lodewave/miata-na-cd/hardware/kicad/NACD.kicad_sch

## KiCad design hardware/kicad/NACD.kicad_sch (2026-10-19)

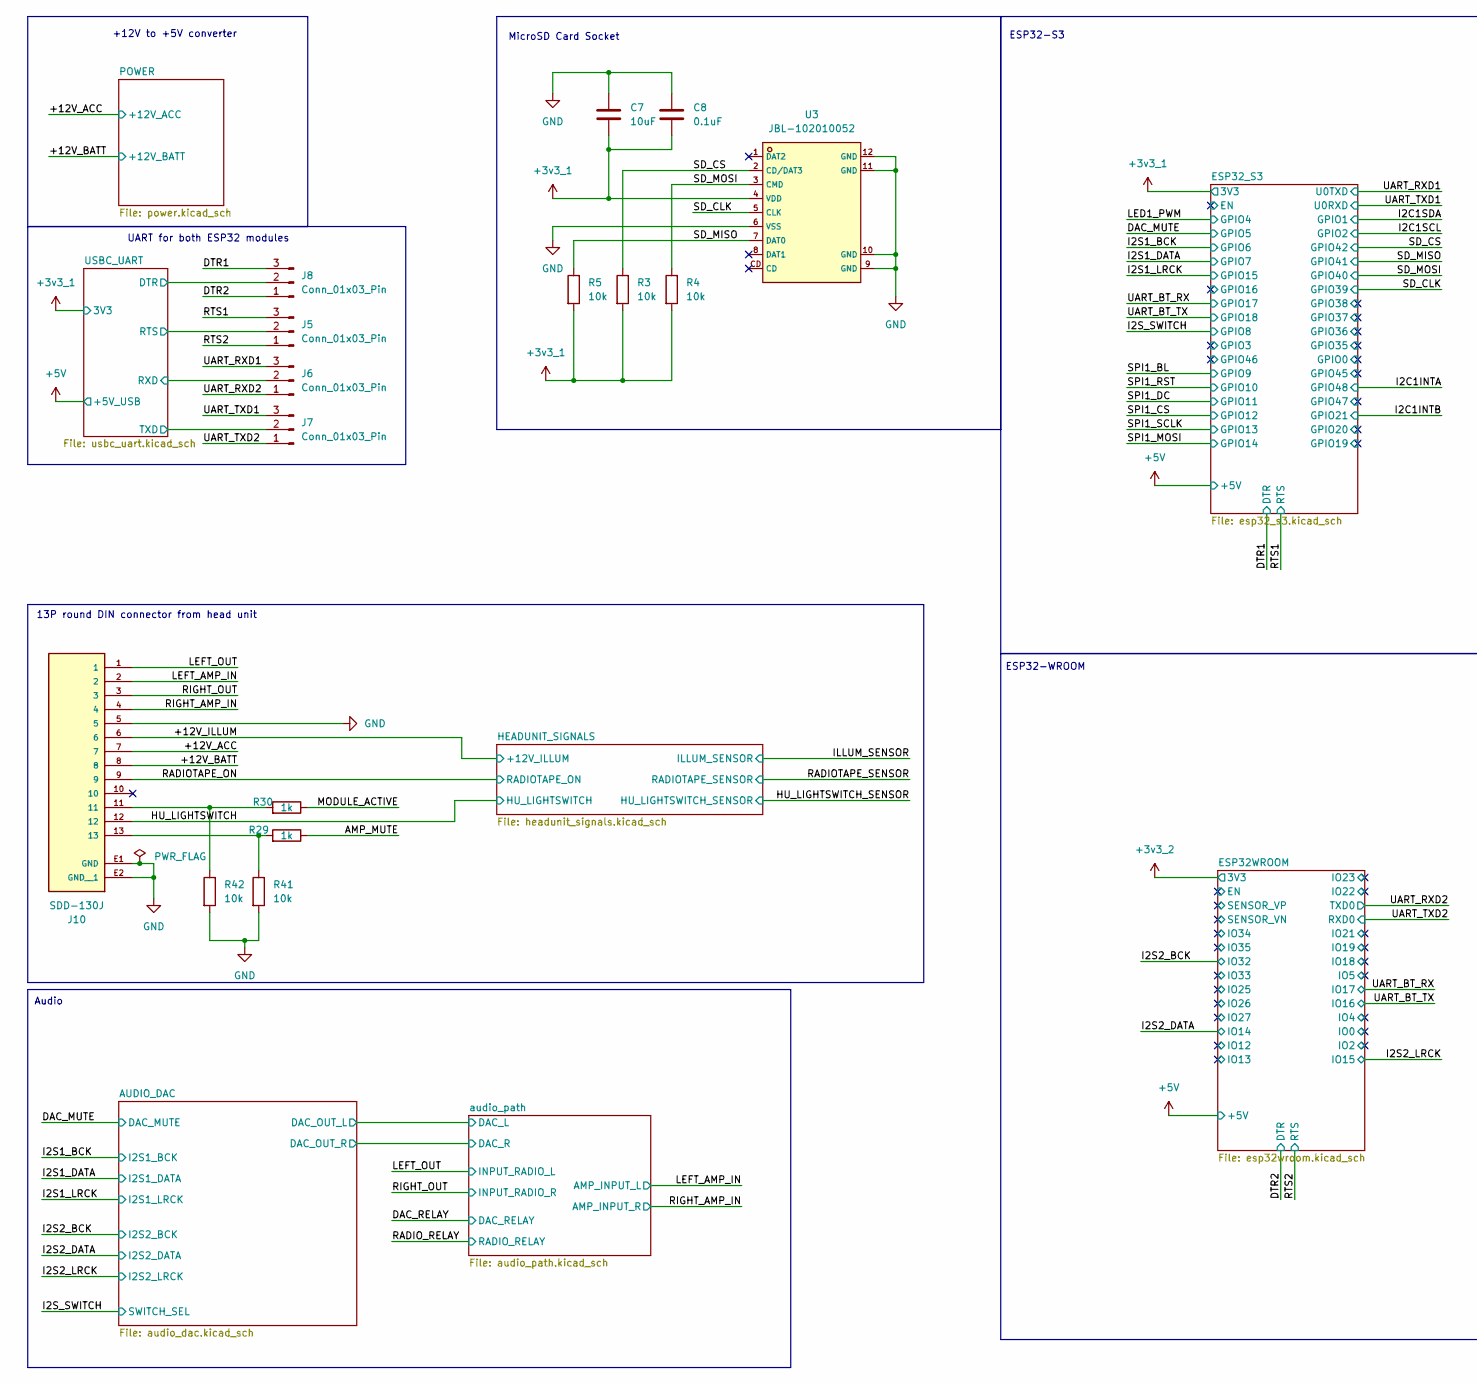
[picture p1: schematic NACD.kicad_sch, part in row 1, column 1]

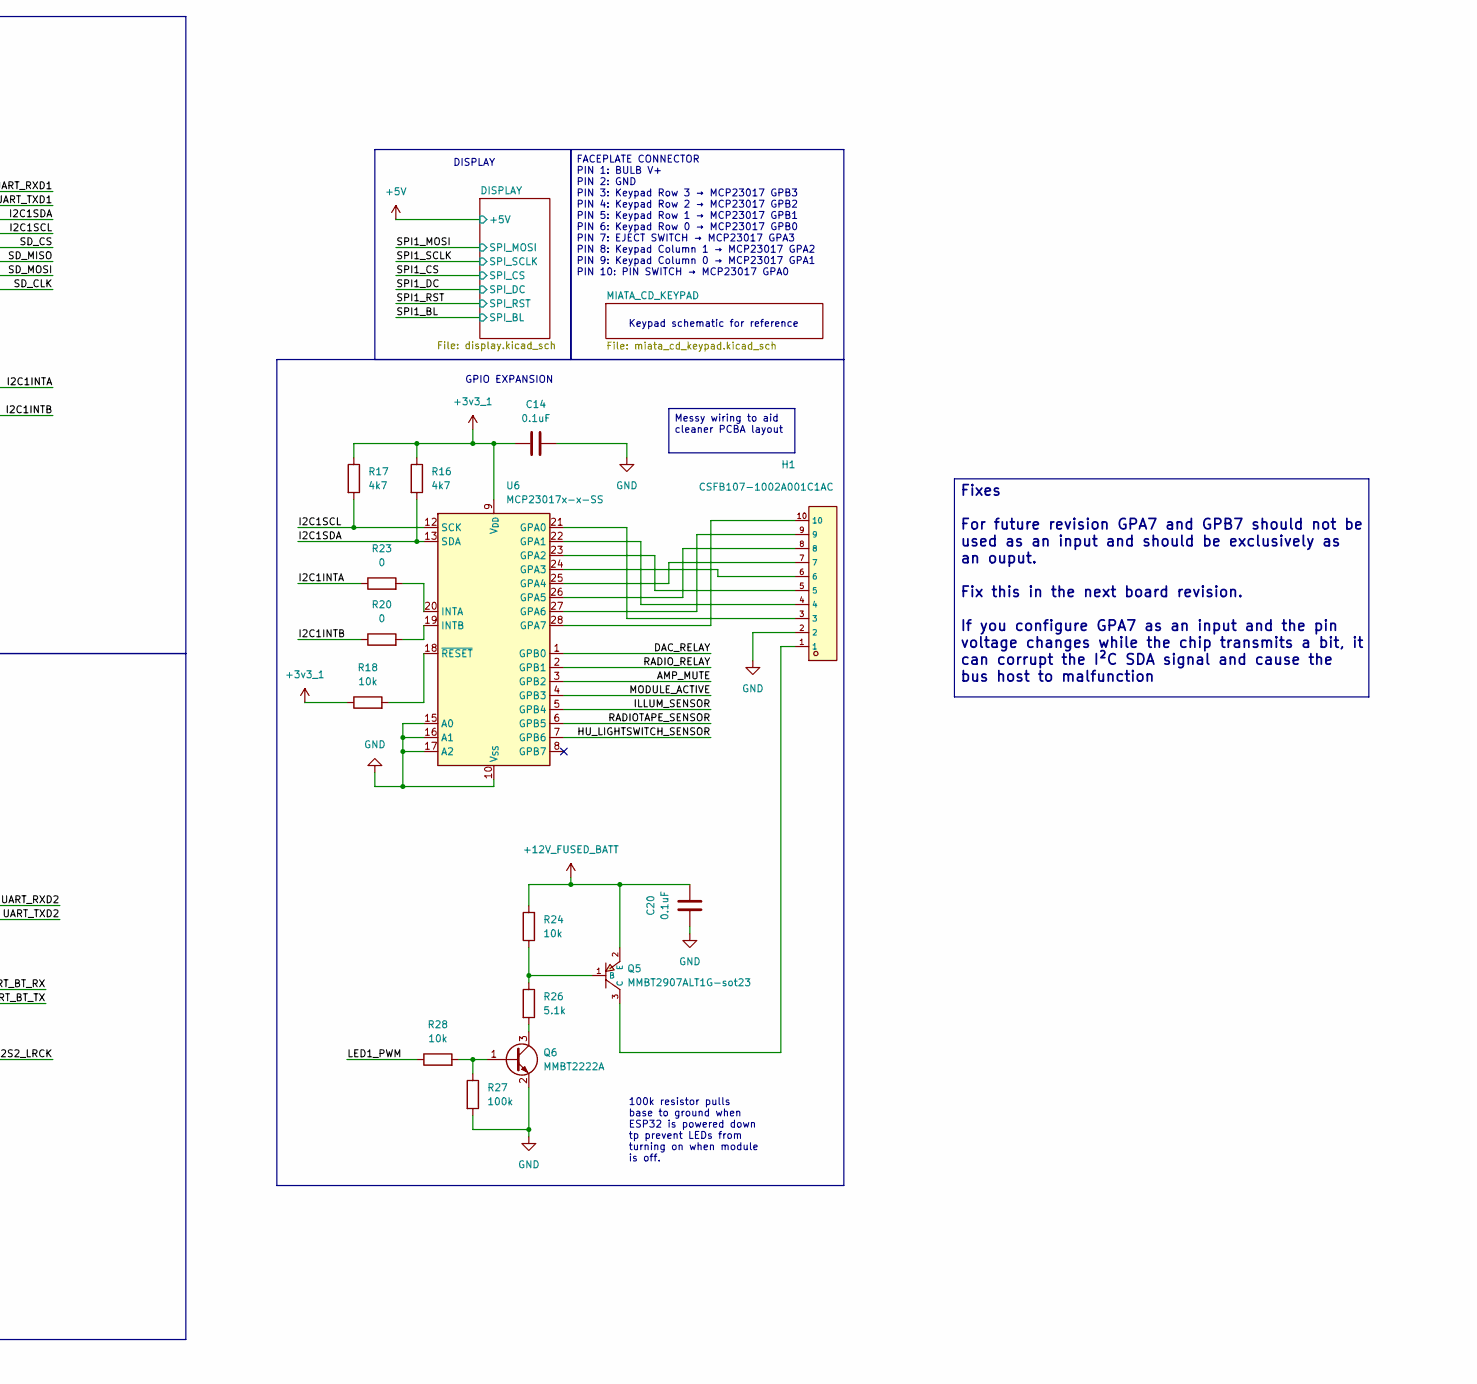
[picture p2: schematic NACD.kicad_sch, part in row 1, column 2]

Parts:
C7: 10uF; C_0603_1608Metric; LCSC C19702
C8, C14, C20: 0.1uF; C_0603_1608Metric; LCSC C14663
H1: CSFB107-1002A001C1AC; C5138915_HDR-TH_10P-P2_00_CSFB107-1002A001C1AC; LCSC C5138915
J5, J6, J7, J8: Conn_01x03_Pin; PinHeader_1x03_P2.54mm_Vertical; LCSC C49257
J10: SDD-130J; CUI_SDD-130J; PARTREV 1.06/02-13-2020
Q5: MMBT2907ALT1G-sot23; C40752_SOT-23-3_L2_9-W1_3-P1_90-LS2_4-BR; LCSC C40752
Q6: MMBT2222A; SOT-23; LCSC C8512
R3, R4, R5, R18, R24, R28, R41, R42: 10k; R_0603_1608Metric; LCSC C25804
R16, R17: 4k7; R_0603_1608Metric; LCSC C23162
R20, R23: 0; R_0603_1608Metric; LCSC C21189
R26: 5.1k; R_0603_1608Metric; LCSC C23186
R27: 100k; R_0603_1608Metric; LCSC C25803
R29, R30: 1k; R_0603_1608Metric; LCSC C21190
U3: JBL-102010052; C49441431_TF-CARD-SMD_JBL-102010052; LCSC C49441431
U6: MCP23017x-x-SS; SSOP-28_5.3x10.2mm_P0.65mm; LCSC C506653

Connections:
+3v3_1: C7.2, C8.2, C14.1, R3.2, R4.2, R5.2, R16.1, R17.1, R18.1, U3.4 (VDD), U6.9 (V_{DD})
+12V_ACC: J10.7
+12V_BATT: J10.8
+12V_FUSED_BATT: C20.2, Q5.2 (E), R24.2
+12V_ILLUM: J10.6
AMP_MUTE: R29.1, U6.3 (GPB2)
DAC_RELAY: U6.1 (GPB0)
DTR: J8.2
DTR1: J8.3
DTR2: J8.1
GND: C7.1, C8.1, C14.2, C20.1, H1.2, J10.5, J10.E1 (GND), J10.E2 (GND__1), Q6.2 (E), R27.2, R41.2, R42.2, U3.6 (VSS), U3.9 (GND), U3.10 (GND), U3.11 (GND), U3.12 (GND), U6.10 (V_{SS}), U6.15 (A0), U6.16 (A1), U6.17 (A2)
HU_LIGHTSWITCH: J10.12
HU_LIGHTSWITCH_SENSOR: U6.7 (GPB6)
I2C1INTA: R23.1
I2C1INTB: R20.1
I2C1SCL: R17.2, U6.12 (SCK)
I2C1SDA: R16.2, U6.13 (SDA)
ILLUM_SENSOR: U6.5 (GPB4)
LED1_PWM: R28.1
LEFT_AMP_IN: J10.2
LEFT_OUT: J10.1
MODULE_ACTIVE: R30.1, U6.4 (GPB3)
unnamed: H1.1, Q5.3 (C)
unnamed: H1.3, U6.21 (GPA0)
unnamed: H1.4, U6.22 (GPA1)
unnamed: H1.5, U6.23 (GPA2)
unnamed: H1.6, U6.24 (GPA3)
unnamed: H1.7, U6.25 (GPA4)
unnamed: H1.8, U6.26 (GPA5)
unnamed: H1.9, U6.27 (GPA6)
unnamed: H1.10, U6.28 (GPA7)
unnamed: J10.11, R30.2, R42.1
unnamed: J10.13, R29.2, R41.1
unnamed: Q5.1 (B), R24.1, R26.1
unnamed: Q6.1 (B), R27.1, R28.2
unnamed: Q6.3 (C), R26.2
unnamed: R18.2, U6.18 (~RESET)
unnamed: R20.2, U6.19 (INTB)
unnamed: R23.2, U6.20 (INTA)
RADIOTAPE_ON: J10.9
RADIOTAPE_SENSOR: U6.6 (GPB5)
RADIO_RELAY: U6.2 (GPB1)
RIGHT_AMP_IN: J10.4
RIGHT_OUT: J10.3
RTS: J5.2
RTS1: J5.3
RTS2: J5.1
RXD: J6.2
SD_CLK: U3.5 (CLK)
SD_CS: R3.1, U3.2 (CD/DAT3)
SD_MISO: R5.1, U3.7 (DAT0)
SD_MOSI: R4.1, U3.3 (CMD)
TXD: J7.2
UART_RXD1: J6.3
UART_RXD2: J6.1
UART_TXD1: J7.3
UART_TXD2: J7.1

Notes on the sheet:
GPIO EXPANSION
Audio
Keypad schematic for reference
13P round DIN connector from head unit
+12V to +5V converter
ESP32-WROOM
DISPLAY
ESP32-S3
MicroSD Card Socket
UART for both ESP32 modules
100k resistor pulls base to ground when ESP32 is powered down tp prevent LEDs from turning on when module is off.
Fixes For future revision GPA7 and GPB7 should not be used as an input and should be exclusively as an ouput. Fix this in the next board revision. If you configure GPA7 as an input and the pin voltage changes while the chip transmits a bit, it can corrupt the I²C SDA signal and cause the bus host t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
FACEPLATE CONNECTOR PIN 1: BULB V+ PIN 2: GND PIN 3: Keypad Row 3 → MCP23017 GPB3 PIN 4: Keypad Row 2 → MCP23017 GPB2 PIN 5: Keypad Row 1 → MCP23017 GPB1 PIN 6: Keypad Row 0 → MCP23017 GPB0 PIN 7: EJECT SWITCH → MCP23017 GPA3 PIN 8: Keypad Column 1 → MCP23017 GPA2 PIN 9: Keypad Column 0 → MCP23017 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
Messy wiring to aid cleaner PCBA layout
