lodewave/miata-na-cd/hardware/kicad/audio_dac.kicad_sch

## KiCad design hardware/kicad/audio_dac.kicad_sch (2026-10-19)

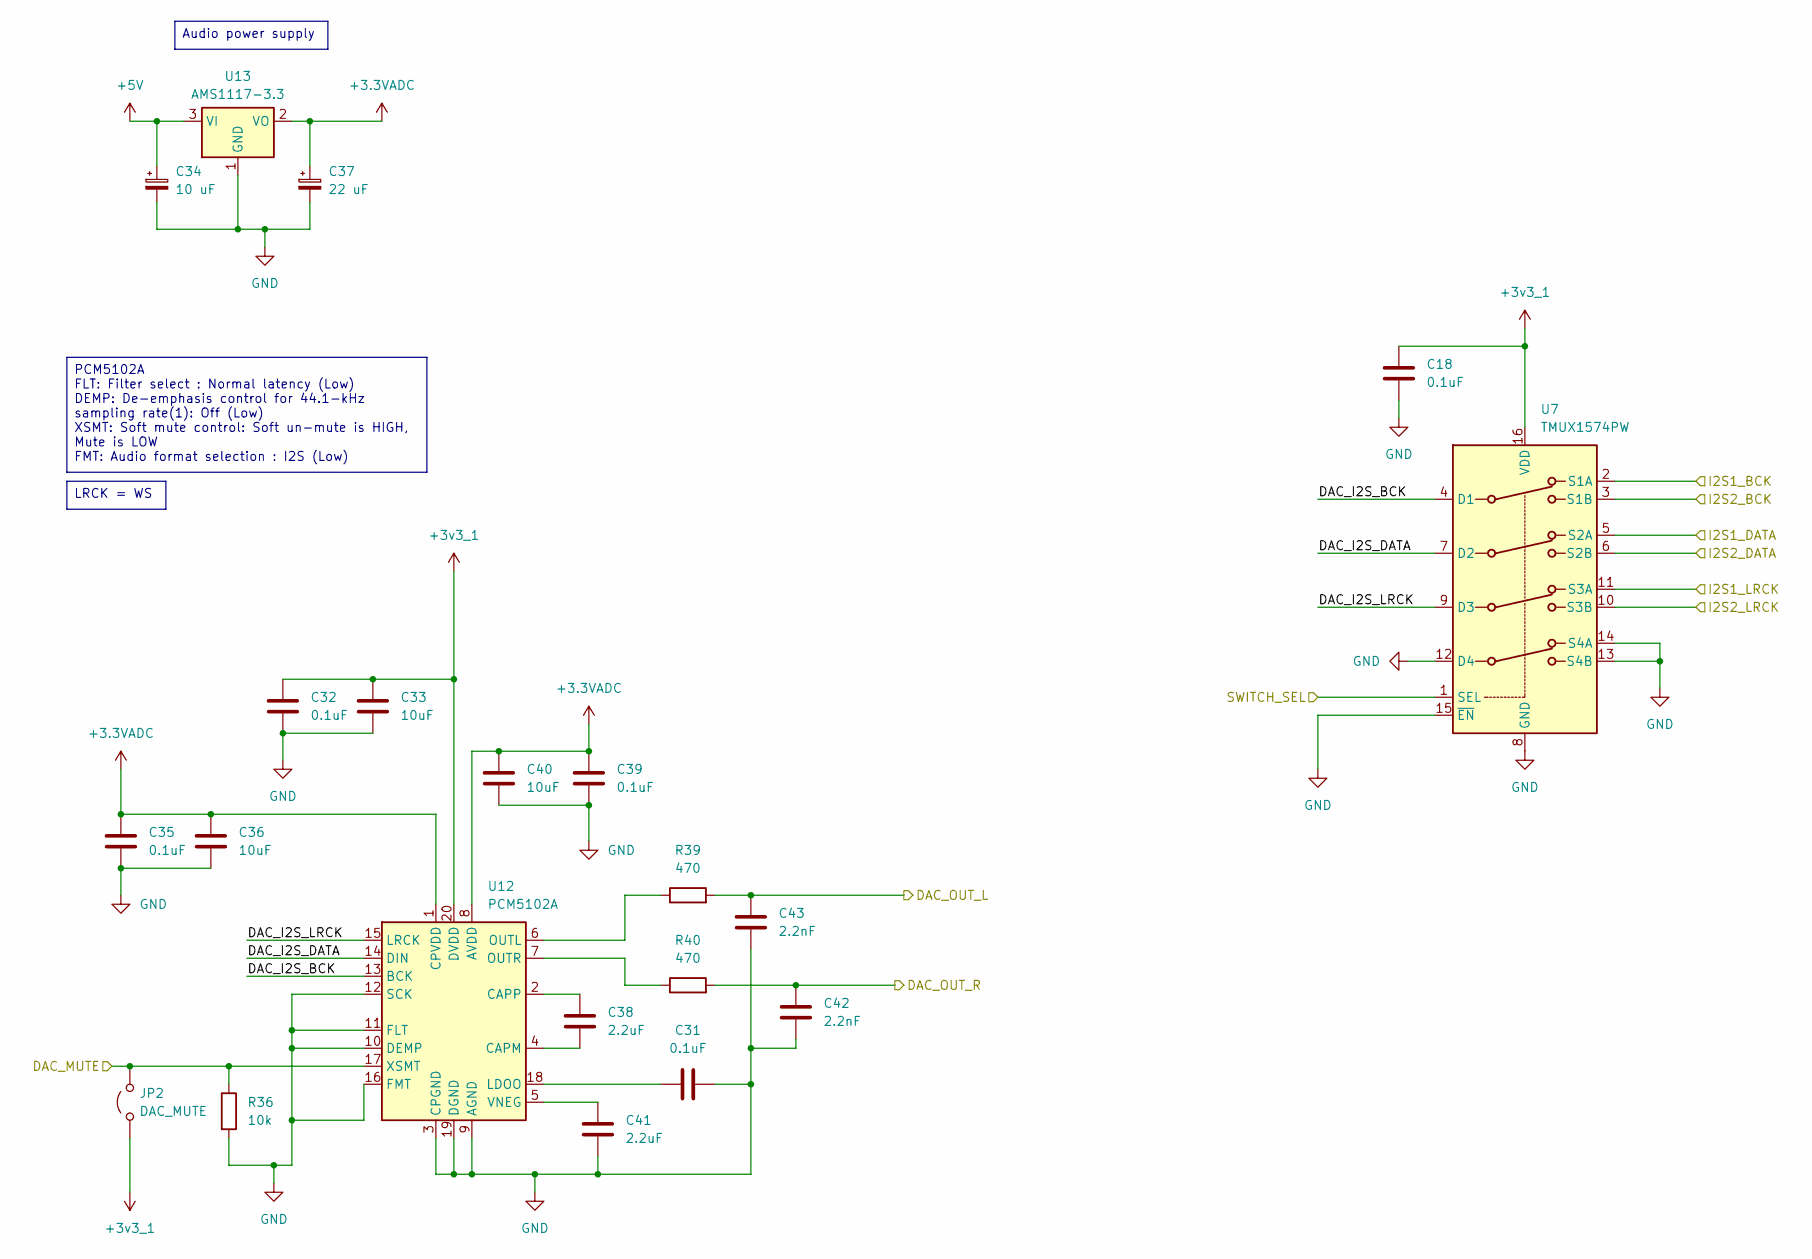
[picture p3: schematic audio_dac.kicad_sch]

Parts:
C18, C31, C32, C35, C39: 0.1uF; C_0603_1608Metric; LCSC C14663
C33, C36, C40: 10uF; C_0603_1608Metric; LCSC C19702
C34: 10 uF; CP_EIA-3216-18_Kemet-A; LCSC C7171
C37: 22 uF; CP_EIA-3216-18_Kemet-A; LCSC C7183
C38, C41: 2.2uF; C_0603_1608Metric; LCSC C23630
C42, C43: 2.2nF; C_0603_1608Metric; LCSC C1604
JP2: DAC_MUTE; PinHeader_1x02_P2.54mm_Vertical; LCSC C5116481
R36: 10k; R_0603_1608Metric; LCSC C25804
R39, R40: 470; R_0603_1608Metric; LCSC C23179
U7: TMUX1574PW; TSSOP-16_4.4x5mm_P0.65mm; LCSC C2673443
U12: PCM5102A; TSSOP-20_4.4x6.5mm_P0.65mm; LCSC C107671
U13: AMS1117-3.3; SOT-223-3_TabPin2; LCSC C6186

Connections:
+3.3VADC: C35.1, C36.1, C37.1, C39.1, C40.1, U12.1 (CPVDD), U12.8 (AVDD), U13.2 (VO)
+3v3_1: C18.1, C32.1, C33.1, JP2.1 (A), U7.16 (VDD), U12.20 (DVDD)
+5V: C34.1, U13.3 (VI)
DAC_I2S_BCK: U7.4 (D1), U12.13 (BCK)
DAC_I2S_DATA: U7.7 (D2), U12.14 (DIN)
DAC_I2S_LRCK: U7.9 (D3), U12.15 (LRCK)
DAC_MUTE: JP2.2 (B), R36.1, U12.17 (XSMT)
DAC_OUT_L: C43.1, R39.2
DAC_OUT_R: C42.1, R40.2
GND: C18.2, C31.2, C32.2, C33.2, C34.2, C35.2, C36.2, C37.2, C39.2, C40.2, C41.2, C42.2, C43.2, R36.2, U7.8 (GND), U7.12 (D4), U7.13 (S4B), U7.14 (S4A), U7.15 (~EN), U12.3 (CPGND), U12.9 (AGND), U12.10 (DEMP), U12.11 (FLT), U12.12 (SCK), U12.16 (FMT), U12.19 (DGND), U13.1 (GND)
I2S1_BCK: U7.2 (S1A)
I2S1_DATA: U7.5 (S2A)
I2S1_LRCK: U7.11 (S3A)
I2S2_BCK: U7.3 (S1B)
I2S2_DATA: U7.6 (S2B)
I2S2_LRCK: U7.10 (S3B)
unnamed: C31.1, U12.18 (LDOO)
unnamed: C38.1, U12.2 (CAPP)
unnamed: C38.2, U12.4 (CAPM)
unnamed: C41.1, U12.5 (VNEG)
unnamed: R39.1, U12.6 (OUTL)
unnamed: R40.1, U12.7 (OUTR)
SWITCH_SEL: U7.1 (SEL)

Notes on the sheet:
Audio power supply
PCM5102A FLT: Filter select : Normal latency (Low) DEMP: De-emphasis control for 44.1-kHz sampling rate(1): Off (Low) XSMT: Soft mute control: Soft un-mute is HIGH, Mute is LOW FMT: Audio format selection : I2S (Low)
LRCK = WS
