lodewave/miata-na-cd/hardware/kicad/audio_path.kicad_sch

## KiCad design hardware/kicad/audio_path.kicad_sch (2026-10-19)

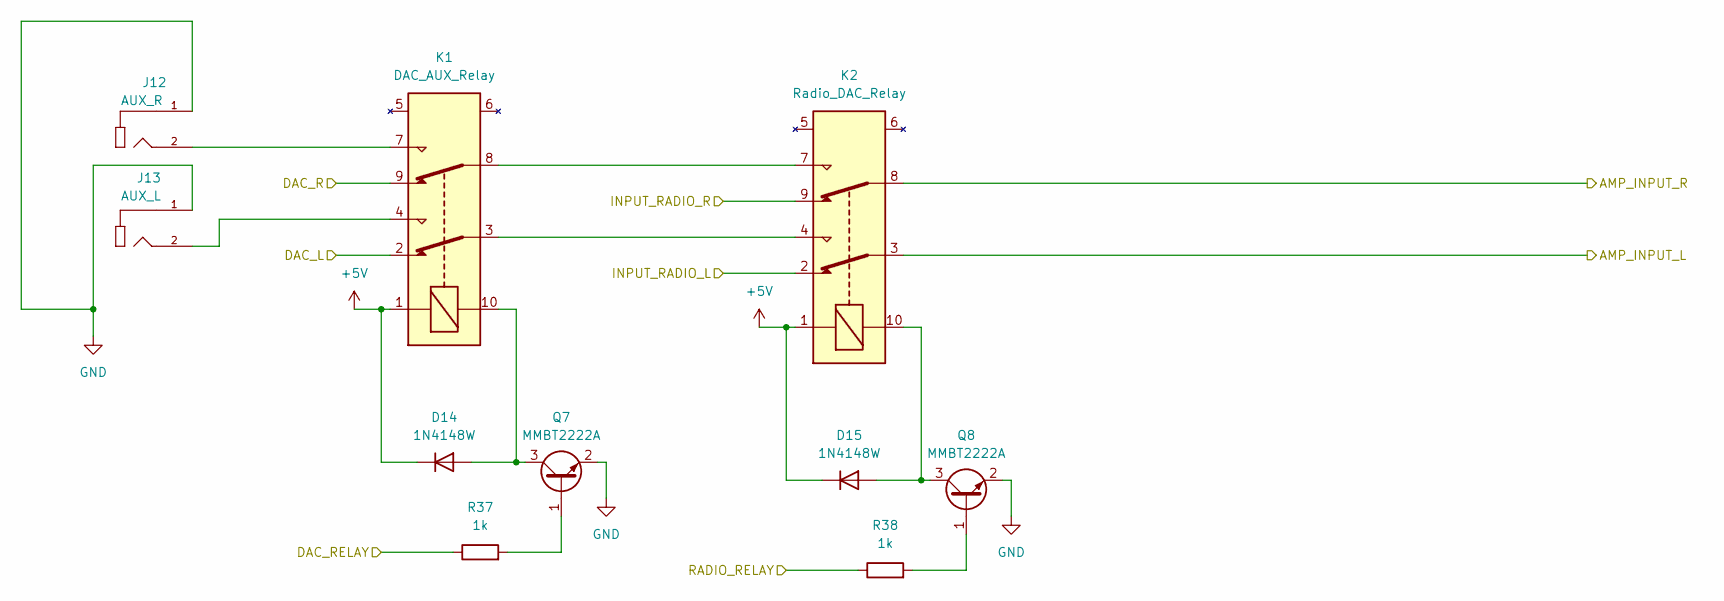
[picture p4: schematic audio_path.kicad_sch]

Parts:
D14, D15: 1N4148W; D_SOD-123; LCSC C81598
J12: AUX_R; C18080_CONN-TH_AV-5; LCSC C18080
J13: AUX_L; C18080_CONN-TH_AV-5; LCSC C18080
K1: DAC_AUX_Relay; Relay_DPDT_FRT5; LCSC C46047
K2: Radio_DAC_Relay; Relay_DPDT_FRT5; LCSC C46047
Q7, Q8: MMBT2222A; SOT-23; LCSC C8512
R37, R38: 1k; R_0603_1608Metric; LCSC C21190

Connections:
+5V: D14.1 (K), D15.1 (K), K1.1, K2.1
AMP_INPUT_L: K2.3
AMP_INPUT_R: K2.8
DAC_L: K1.2
DAC_R: K1.9
DAC_RELAY: R37.1
GND: J12.1, J13.1, Q7.2 (E), Q8.2 (E)
INPUT_RADIO_L: K2.2
INPUT_RADIO_R: K2.9
unnamed: D14.2 (A), K1.10, Q7.3 (C)
unnamed: D15.2 (A), K2.10, Q8.3 (C)
unnamed: J12.2, K1.7
unnamed: J13.2, K1.4
unnamed: K1.3, K2.4
unnamed: K1.8, K2.7
unnamed: Q7.1 (B), R37.2
unnamed: Q8.1 (B), R38.2
RADIO_RELAY: R38.1
