lodewave/miata-na-cd/hardware/kicad/display.kicad_sch

## KiCad design hardware/kicad/display.kicad_sch (2026-10-19)

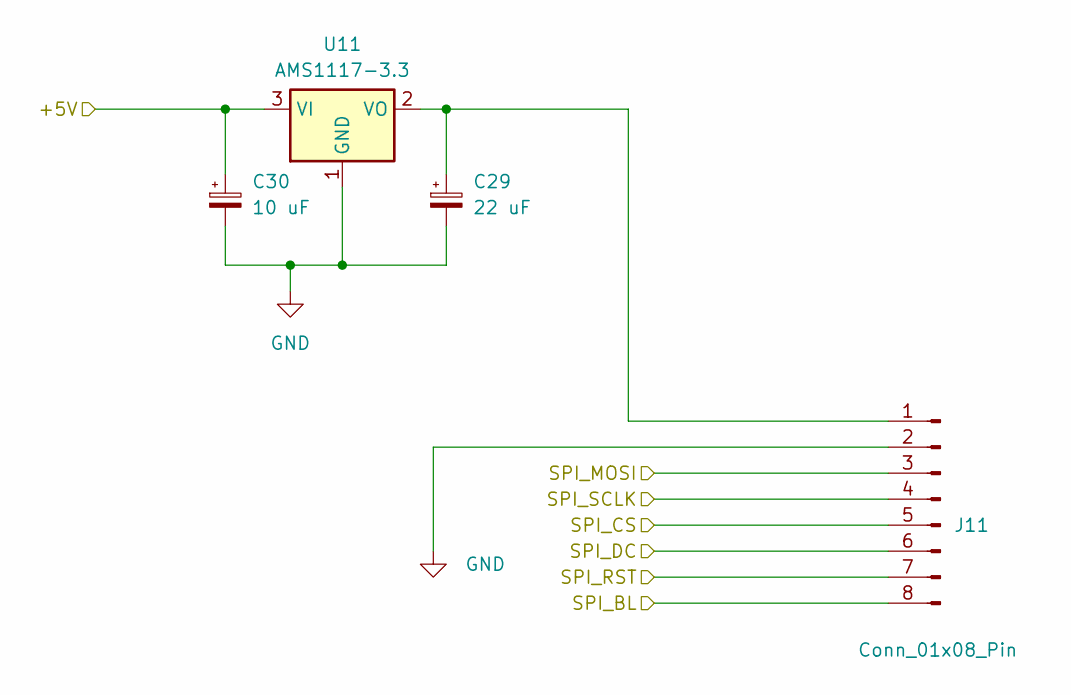
[picture p5: schematic display.kicad_sch]

Parts:
C29: 22 uF; CP_EIA-3216-18_Kemet-A; LCSC C7183
C30: 10 uF; CP_EIA-3216-18_Kemet-A; LCSC C7171
J11: Conn_01x08_Pin; PinHeader_1x08_P2.54mm_Vertical; LCSC C5156616
U11: AMS1117-3.3; SOT-223-3_TabPin2; LCSC C6186

Connections:
+5V: C30.1, U11.3 (VI)
GND: C29.2, C30.2, J11.2, U11.1 (GND)
unnamed: C29.1, J11.1, U11.2 (VO)
SPI_BL: J11.8
SPI_CS: J11.5
SPI_DC: J11.6
SPI_MOSI: J11.3
SPI_RST: J11.7
SPI_SCLK: J11.4
