lodewave/miata-na-cd/hardware/kicad/esp32_s3.kicad_sch

## KiCad design hardware/kicad/esp32_s3.kicad_sch (2026-10-19)

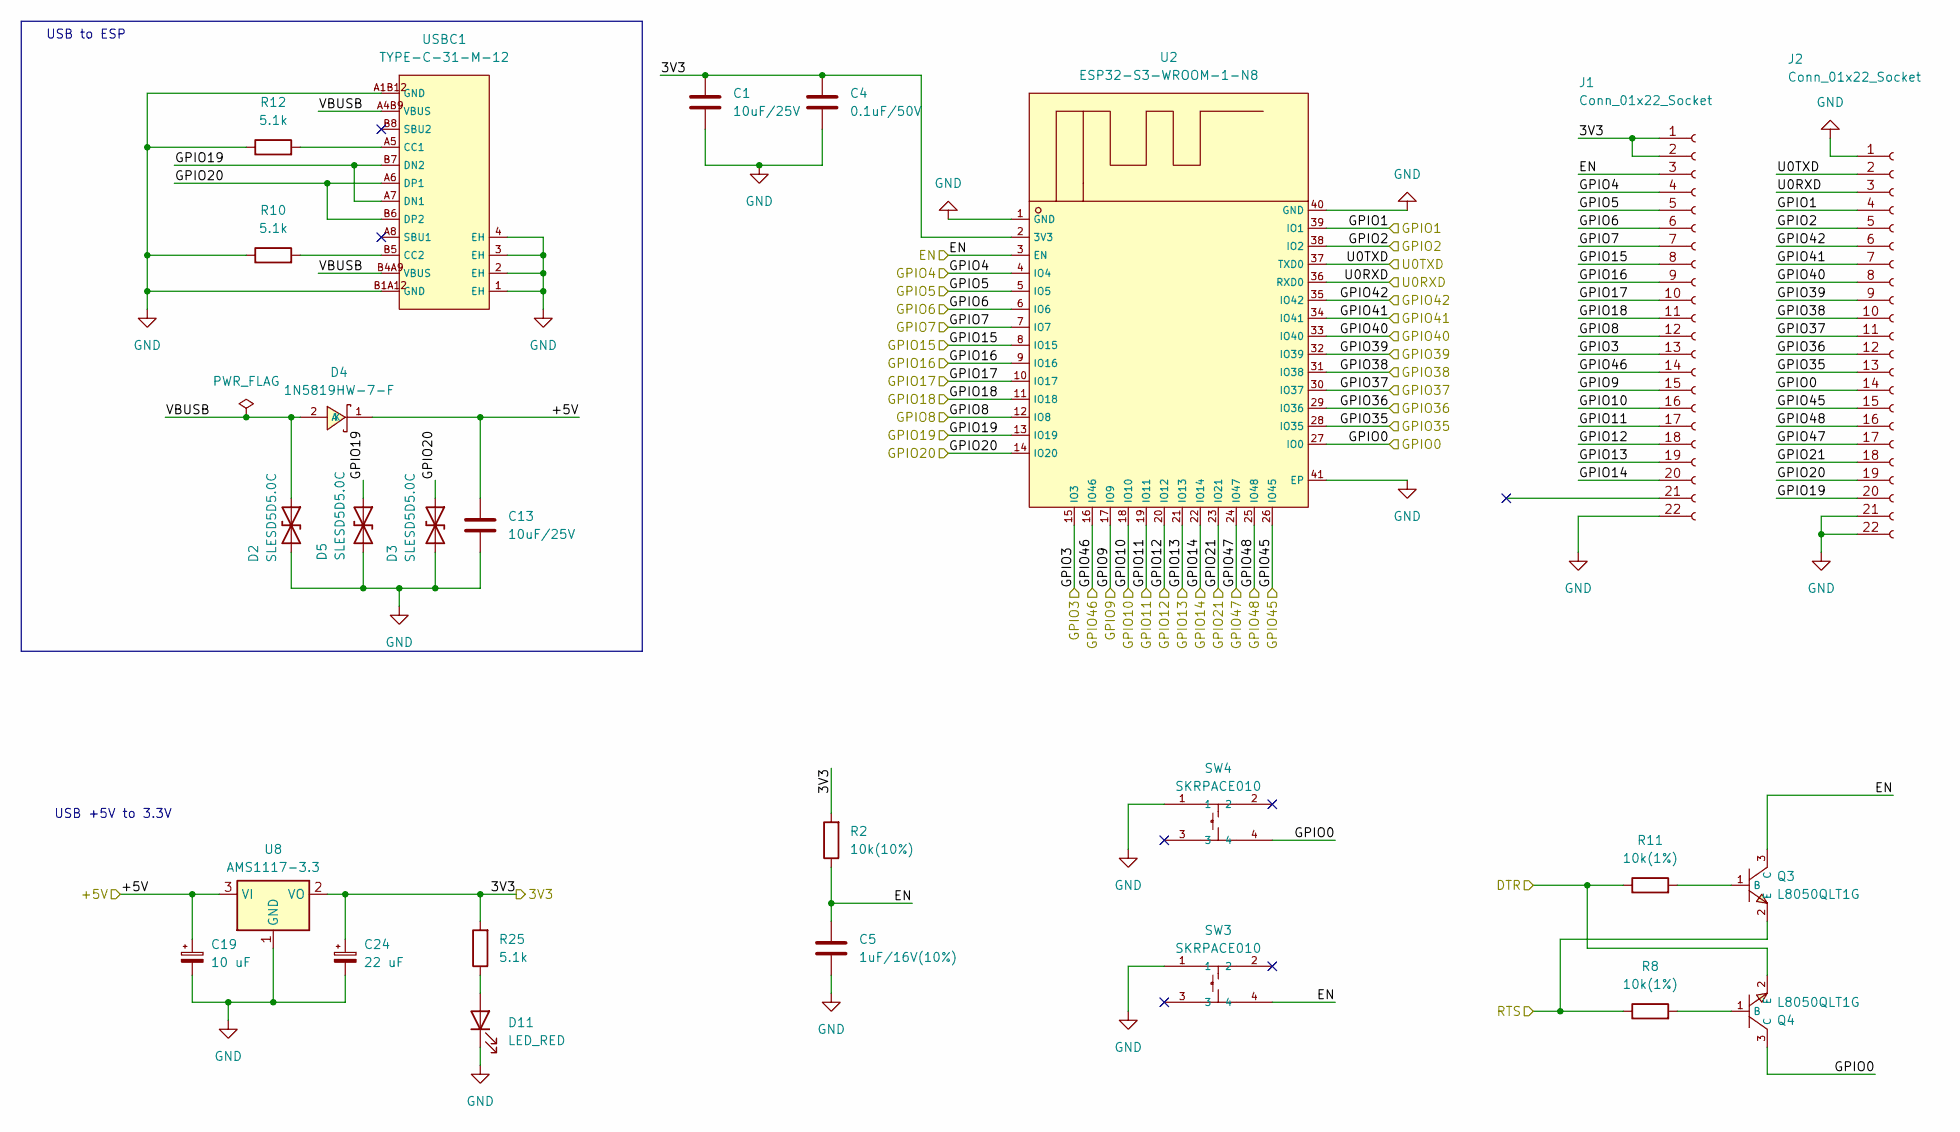
[picture p6: schematic esp32_s3.kicad_sch]

Parts:
C1, C13: 10uF/25V; C_0603_1608Metric; LCSC C96446
C4: 0.1uF/50V; C_0603_1608Metric; LCSC C14663
C5: 1uF/16V(10%); C_0603_1608Metric; LCSC C15849
C19: 10 uF; CP_EIA-3216-18_Kemet-A; LCSC C7171
C24: 22 uF; CP_EIA-3216-18_Kemet-A; LCSC C7183
D2, D3, D5: SLESD5D5.0C; D_SOD-523; LCSC C52311731
D4: 1N5819HW-7-F; D_SOD-323_HandSoldering; LCSC C191023
D11: LED_RED; LED_0201_0603Metric; LCSC C3646923
J1, J2: Conn_01x22_Socket; PinHeader_1x22_P2.54mm_Vertical; LCSC C2886702
Q3, Q4: L8050QLT1G; C49581_SOT-23-3_L2_9-W1_3-P1_90-LS2_4-BR; LCSC C2150
R2: 10k(10%); R_0603_1608Metric; LCSC C25804
R8, R11: 10k(1%); R_0603_1608Metric; LCSC C25804
R10, R12, R25: 5.1k; R_0603_1608Metric; LCSC C23186
SW3, SW4: SKRPACE010; C139797_KEY-SMD_4P-L4_2-W3_2-P2_20-LS4_6; LCSC C139797
U2: ESP32-S3-WROOM-1-N8; C2913198_WIFIM-SMD_ESP32-S3-WROOM-1-N8; LCSC C2913198
U8: AMS1117-3.3; SOT-223-3_TabPin2; LCSC C6186
USBC1: TYPE-C-31-M-12; C165948_USB-C_SMD-TYPE-C-31-M-12_1; LCSC C165948

Connections:
3V3: C1.1, C4.1, C24.1, J1.1, J1.2, R2.2, R25.2, U2.2 (3V3), U8.2 (VO)
+5V: C13.1, C19.1, D4.1 (K), U8.3 (VI)
DTR: Q4.2 (E), R11.1
EN: C5.2, J1.3, Q3.3 (C), R2.1, SW3.4, U2.3 (EN)
GND: C1.2, C4.2, C5.1, C13.2, C19.2, C24.2, D2.2 (A2), D3.2 (A2), D5.2 (A2), D11.1 (K), J1.22, J2.1, J2.21, J2.22, R10.1, R12.1, SW3.1, SW4.1, U2.1 (GND), U2.40 (GND), U2.41 (EP), U8.1 (GND), USBC1.1 (EH), USBC1.2 (EH), USBC1.3 (EH), USBC1.4 (EH), USBC1.A1B12 (GND), USBC1.B1A12 (GND)
GPIO0: J2.14, Q4.3 (C), SW4.4, U2.27 (IO0)
GPIO1: J2.4, U2.39 (IO1)
GPIO2: J2.5, U2.38 (IO2)
GPIO3: J1.13, U2.15 (IO3)
GPIO4: J1.4, U2.4 (IO4)
GPIO5: J1.5, U2.5 (IO5)
GPIO6: J1.6, U2.6 (IO6)
GPIO7: J1.7, U2.7 (IO7)
GPIO8: J1.12, U2.12 (IO8)
GPIO9: J1.15, U2.17 (IO9)
GPIO10: J1.16, U2.18 (IO10)
GPIO11: J1.17, U2.19 (IO11)
GPIO12: J1.18, U2.20 (IO12)
GPIO13: J1.19, U2.21 (IO13)
GPIO14: J1.20, U2.22 (IO14)
GPIO15: J1.8, U2.8 (IO15)
GPIO16: J1.9, U2.9 (IO16)
GPIO17: J1.10, U2.10 (IO17)
GPIO18: J1.11, U2.11 (IO18)
GPIO19: D5.1 (A1), J2.20, U2.13 (IO19), USBC1.A7 (DN1), USBC1.B7 (DN2)
GPIO20: D3.1 (A1), J2.19, U2.14 (IO20), USBC1.A6 (DP1), USBC1.B6 (DP2)
GPIO21: J2.18, U2.23 (IO21)
GPIO35: J2.13, U2.28 (IO35)
GPIO36: J2.12, U2.29 (IO36)
GPIO37: J2.11, U2.30 (IO37)
GPIO38: J2.10, U2.31 (IO38)
GPIO39: J2.9, U2.32 (IO39)
GPIO40: J2.8, U2.33 (IO40)
GPIO41: J2.7, U2.34 (IO41)
GPIO42: J2.6, U2.35 (IO42)
GPIO45: J2.15, U2.26 (IO45)
GPIO46: J1.14, U2.16 (IO46)
GPIO47: J2.17, U2.24 (IO47)
GPIO48: J2.16, U2.25 (IO48)
unnamed: D11.2 (A), R25.1
unnamed: Q3.1 (B), R11.2
unnamed: Q4.1 (B), R8.2
unnamed: R10.2, USBC1.B5 (CC2)
unnamed: R12.2, USBC1.A5 (CC1)
RTS: Q3.2 (E), R8.1
U0RXD: J2.3, U2.36 (RXD0)
U0TXD: J2.2, U2.37 (TXD0)
VBUSB: D2.1 (A1), D4.2 (A), USBC1.A4B9 (VBUS), USBC1.B4A9 (VBUS)

Notes on the sheet:
USB to ESP
USB +5V to 3.3V
