lodewave/miata-na-cd/hardware/kicad/esp32wroom.kicad_sch

## KiCad design hardware/kicad/esp32wroom.kicad_sch (2026-10-19)

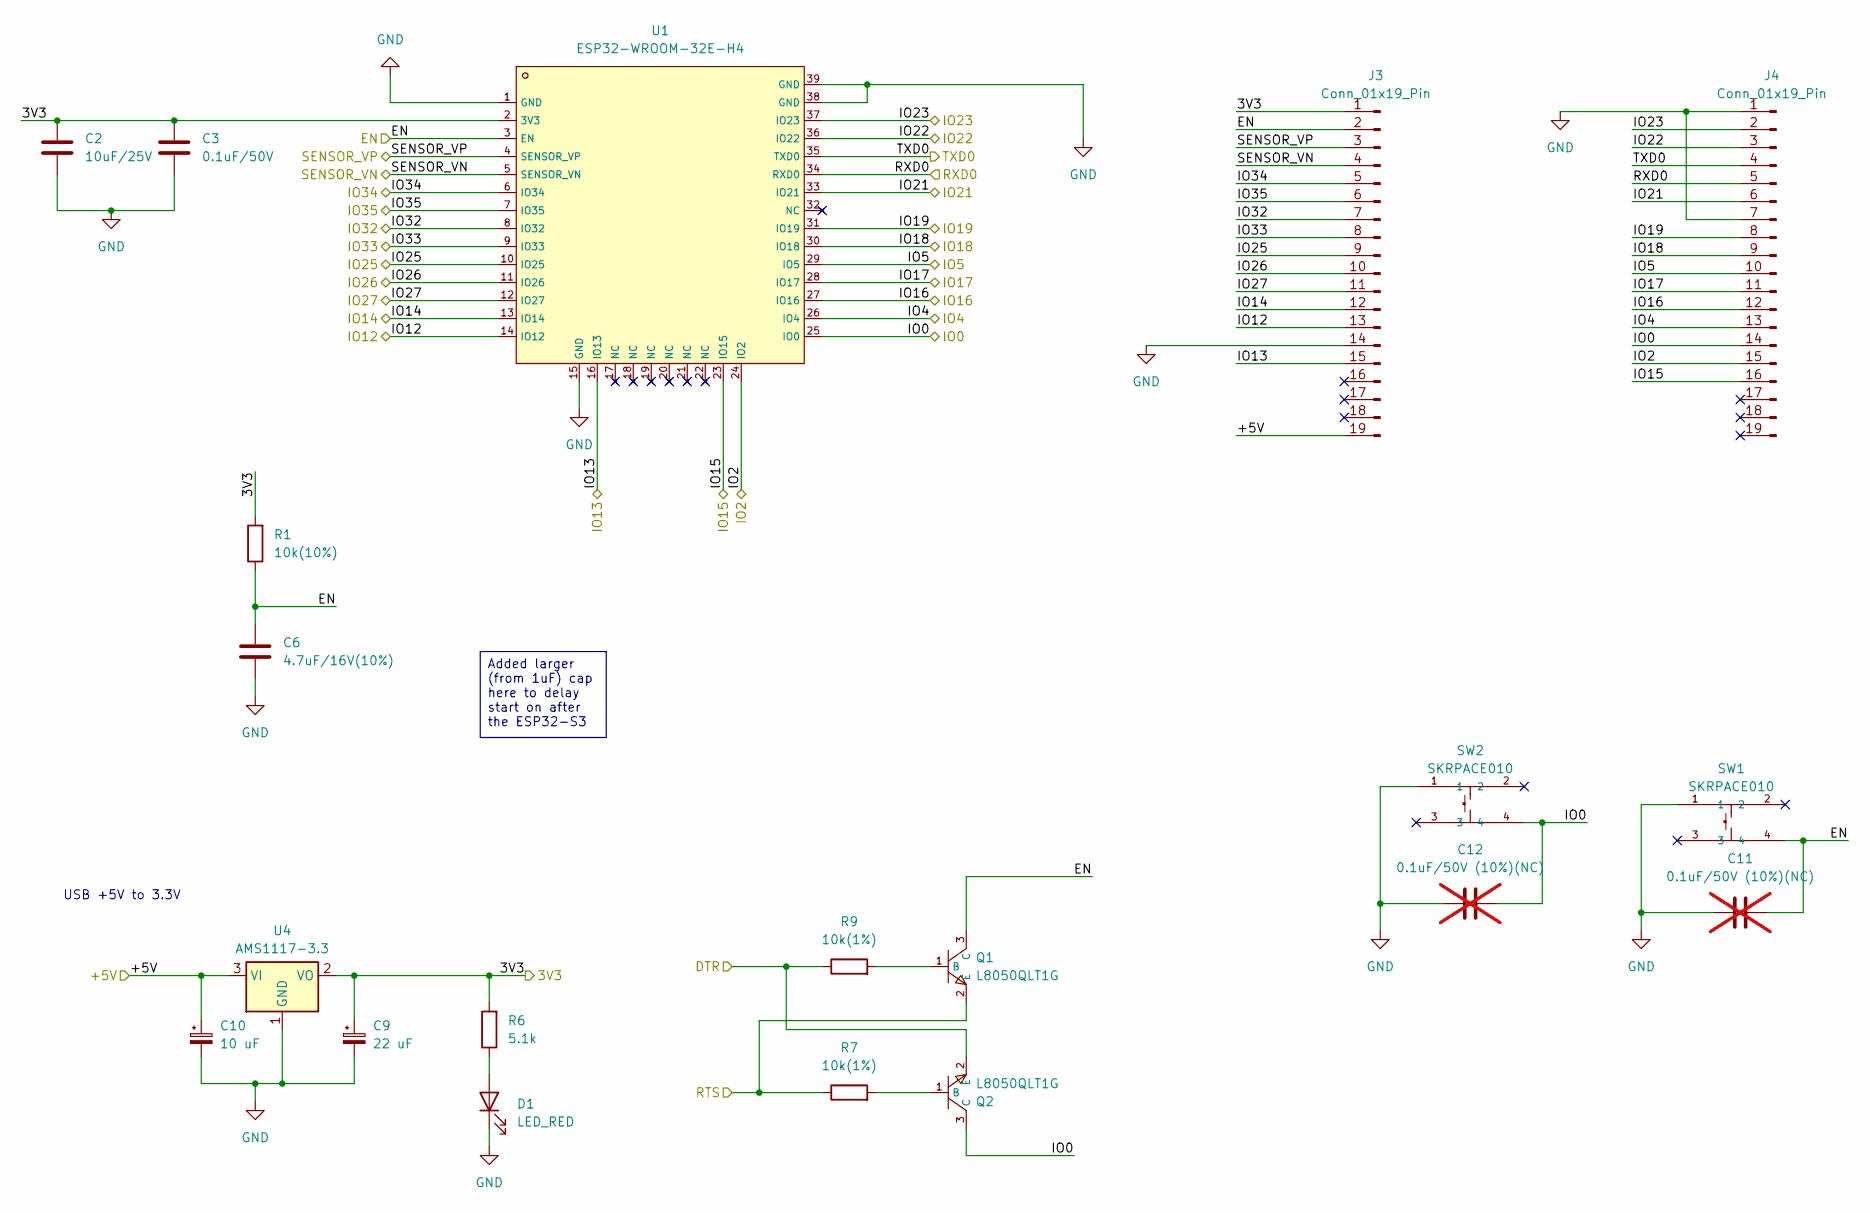
[picture p7: schematic esp32wroom.kicad_sch]

Parts:
C2: 10uF/25V; C_0603_1608Metric; LCSC C96446
C3: 0.1uF/50V; C_0603_1608Metric; LCSC C14663
C6: 4.7uF/16V(10%); C_0603_1608Metric; LCSC C19666
C9: 22 uF; CP_EIA-3216-18_Kemet-A; LCSC C7183
C10: 10 uF; CP_EIA-3216-18_Kemet-A; LCSC C7171
C11, C12: 0.1uF/50V (10%)(NC); C_0603_1608Metric; LCSC C14663; not fitted
D1: LED_RED; LED_0201_0603Metric; LCSC C3646923
J3, J4: Conn_01x19_Pin; PinSocket_1x19_P2.54mm_Vertical; LCSC C319202
Q1, Q2: L8050QLT1G; C49581_SOT-23-3_L2_9-W1_3-P1_90-LS2_4-BR; LCSC C2150
R1: 10k(10%); R_0603_1608Metric; LCSC C25804
R6: 5.1k; R_0603_1608Metric; LCSC C23186
R7, R9: 10k(1%); R_0603_1608Metric; LCSC C25804
SW1, SW2: SKRPACE010; C139797_KEY-SMD_4P-L4_2-W3_2-P2_20-LS4_6; LCSC C139797
U1: ESP32-WROOM-32E-H4; C3013935_WIFI-SMD_ESP32-WROOM-32E; LCSC C3013935
U4: AMS1117-3.3; SOT-223-3_TabPin2; LCSC C6186

Connections:
3V3: C2.1, C3.1, C9.1, J3.1, R1.2, R6.2, U1.2 (3V3), U4.2 (VO)
+5V: C10.1, J3.19, U4.3 (VI)
DTR: Q2.2 (E), R9.1
EN: C6.2, C11.1, J3.2, Q1.3 (C), R1.1, SW1.4, U1.3 (EN)
GND: C2.2, C3.2, C6.1, C9.2, C10.2, C11.2, C12.2, D1.1 (K), J3.14, J4.1, J4.7, SW1.1, SW2.1, U1.1 (GND), U1.15 (GND), U1.38 (GND), U1.39 (GND), U4.1 (GND)
IO0: C12.1, J4.14, Q2.3 (C), SW2.4, U1.25 (IO0)
IO2: J4.15, U1.24 (IO2)
IO4: J4.13, U1.26 (IO4)
IO5: J4.10, U1.29 (IO5)
IO12: J3.13, U1.14 (IO12)
IO13: J3.15, U1.16 (IO13)
IO14: J3.12, U1.13 (IO14)
IO15: J4.16, U1.23 (IO15)
IO16: J4.12, U1.27 (IO16)
IO17: J4.11, U1.28 (IO17)
IO18: J4.9, U1.30 (IO18)
IO19: J4.8, U1.31 (IO19)
IO21: J4.6, U1.33 (IO21)
IO22: J4.3, U1.36 (IO22)
IO23: J4.2, U1.37 (IO23)
IO25: J3.9, U1.10 (IO25)
IO26: J3.10, U1.11 (IO26)
IO27: J3.11, U1.12 (IO27)
IO32: J3.7, U1.8 (IO32)
IO33: J3.8, U1.9 (IO33)
IO34: J3.5, U1.6 (IO34)
IO35: J3.6, U1.7 (IO35)
unnamed: D1.2 (A), R6.1
unnamed: Q1.1 (B), R9.2
unnamed: Q2.1 (B), R7.2
RTS: Q1.2 (E), R7.1
RXD0: J4.5, U1.34 (RXD0)
SENSOR_VN: J3.4, U1.5 (SENSOR_VN)
SENSOR_VP: J3.3, U1.4 (SENSOR_VP)
TXD0: J4.4, U1.35 (TXD0)

Notes on the sheet:
USB +5V to 3.3V
Added larger (from 1uF) cap here to delay start on after the ESP32-S3
