lodewave/miata-na-cd/hardware/kicad/headunit_signals.kicad_sch

## KiCad design hardware/kicad/headunit_signals.kicad_sch (2026-10-19)

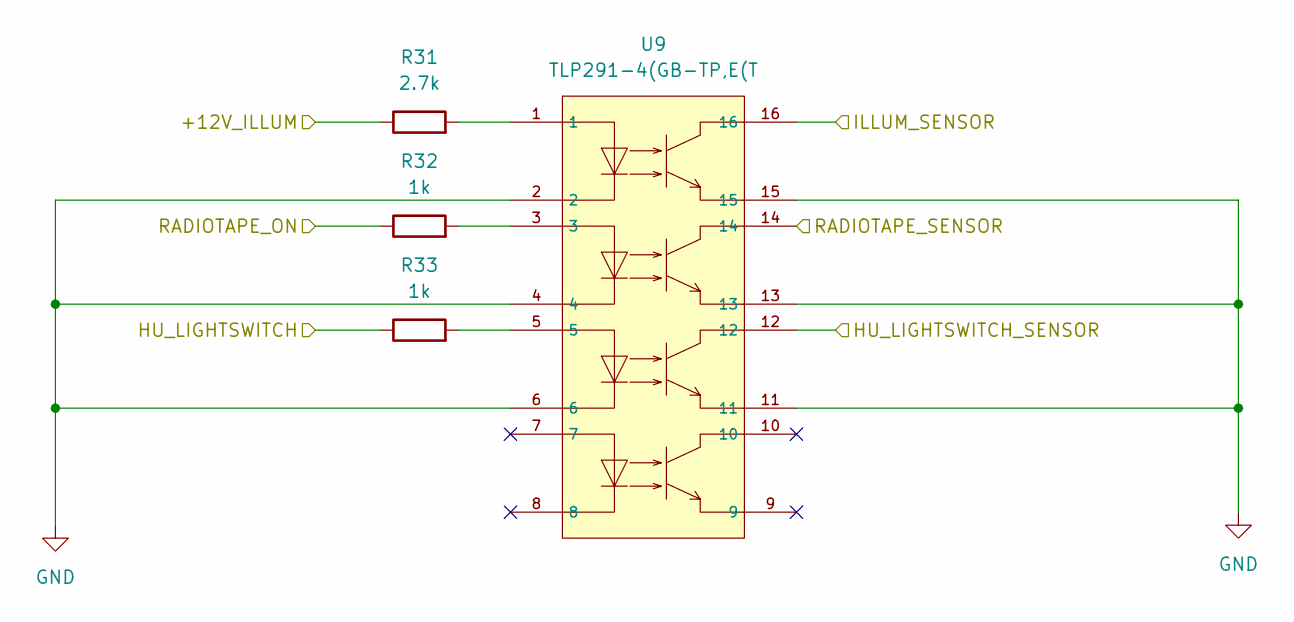
[picture p8: schematic headunit_signals.kicad_sch]

Parts:
R31: 2.7k; R_0603_1608Metric; LCSC C13167
R32, R33: 1k; R_0603_1608Metric; LCSC C21190
U9: TLP291-4(GB-TP,E(T; C60900_SOP-16_L10_3-W4_4-P1_27-LS7_0-BL; LCSC C60900

Connections:
+12V_ILLUM: R31.1
GND: U9.2, U9.4, U9.6, U9.11, U9.13, U9.15
HU_LIGHTSWITCH: R33.1
HU_LIGHTSWITCH_SENSOR: U9.12
ILLUM_SENSOR: U9.16
unnamed: R31.2, U9.1
unnamed: R32.2, U9.3
unnamed: R33.2, U9.5
RADIOTAPE_ON: R32.1
RADIOTAPE_SENSOR: U9.14
