lodewave/miata-na-cd/hardware/kicad/miata_cd_keypad.kicad_sch

## KiCad design hardware/kicad/miata_cd_keypad.kicad_sch (2026-10-19)

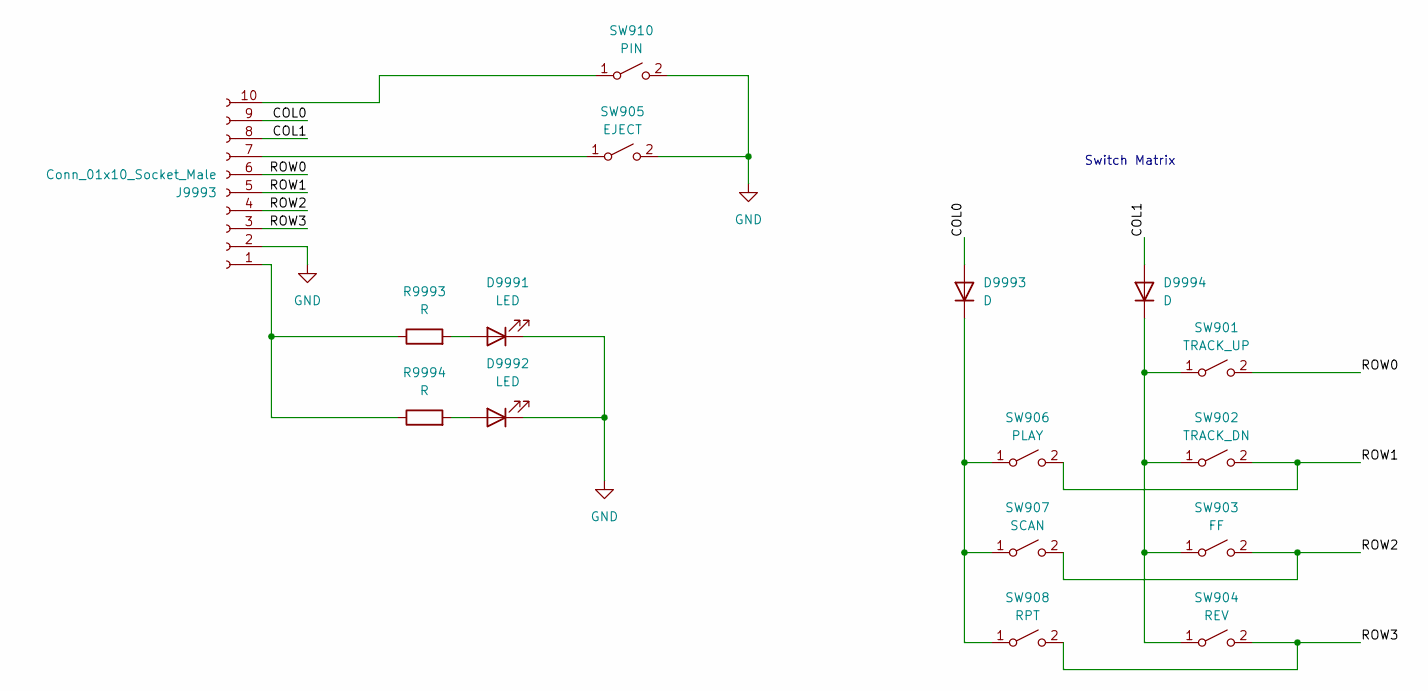
[picture p9: schematic miata_cd_keypad.kicad_sch]

Parts:
D9991, D9992: LED
D9993, D9994: D
J9993: Conn_01x10_Socket_Male
R9993, R9994: R
SW901: TRACK_UP
SW902: TRACK_DN
SW903: FF
SW904: REV
SW905: EJECT
SW906: PLAY
SW907: SCAN
SW908: RPT
SW910: PIN

Connections:
COL0: D9993.2 (A), J9993.9
COL1: D9994.2 (A), J9993.8
GND: D9991.1 (K), D9992.1 (K), J9993.2, SW905.2 (B), SW910.2 (B)
unnamed: D9991.2 (A), R9993.2
unnamed: D9992.2 (A), R9994.2
unnamed: D9993.1 (K), SW906.1 (A), SW907.1 (A), SW908.1 (A)
unnamed: D9994.1 (K), SW901.1 (A), SW902.1 (A), SW903.1 (A), SW904.1 (A)
unnamed: J9993.1, R9993.1, R9994.1
unnamed: J9993.7, SW905.1 (A)
unnamed: J9993.10, SW910.1 (A)
ROW0: J9993.6, SW901.2 (B)
ROW1: J9993.5, SW902.2 (B), SW906.2 (B)
ROW2: J9993.4, SW903.2 (B), SW907.2 (B)
ROW3: J9993.3, SW904.2 (B), SW908.2 (B)

Notes on the sheet:
Switch Matrix
