lodewave/miata-na-cd/hardware/kicad/power.kicad_sch

## KiCad design hardware/kicad/power.kicad_sch (2026-10-19)

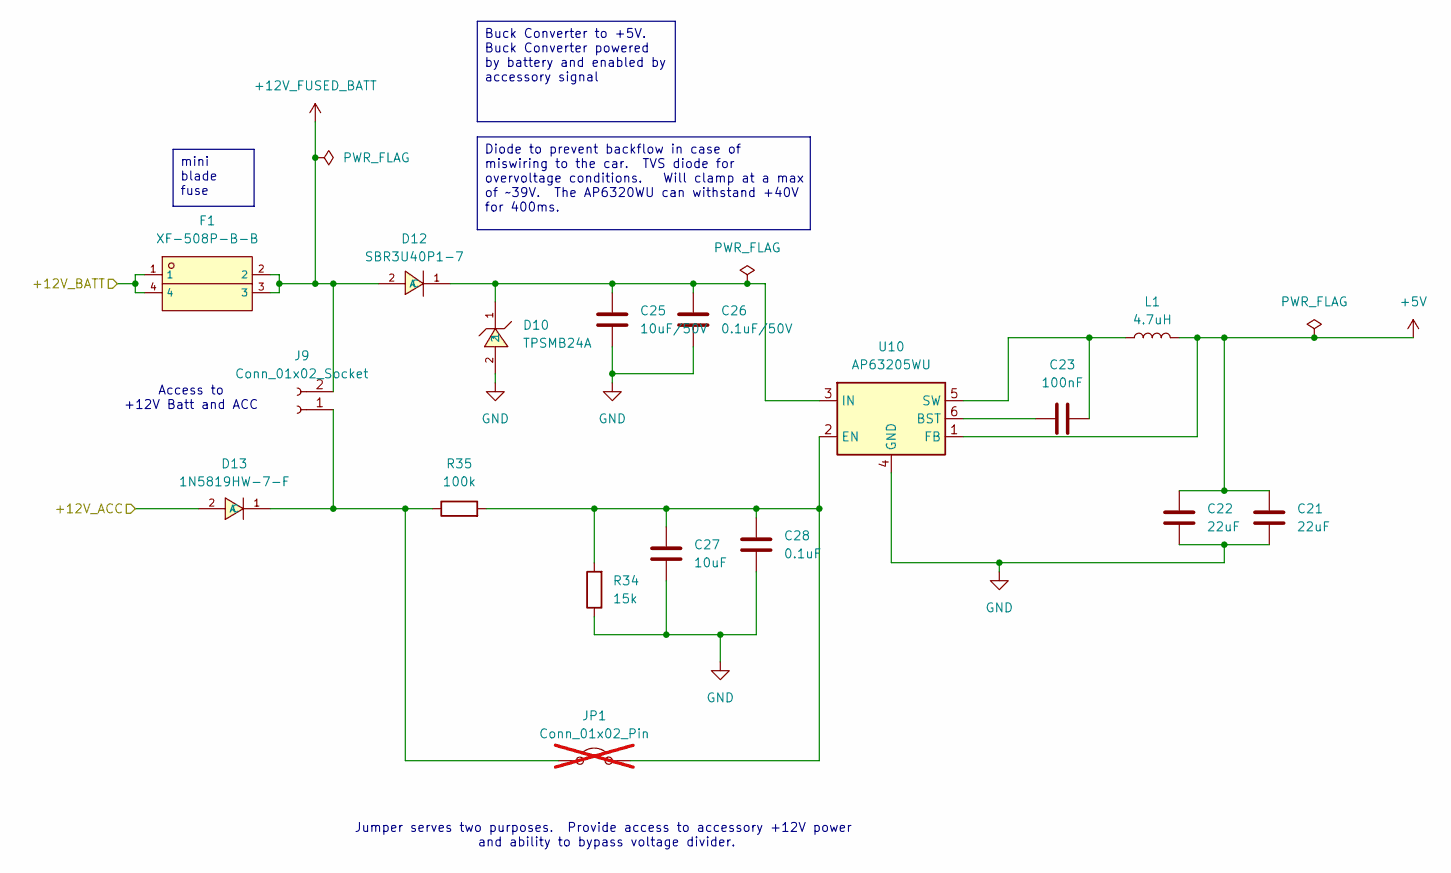
[picture p10: schematic power.kicad_sch]

Parts:
C21, C22: 22uF; C_1206_3216Metric; LCSC C12891
C23: 100nF; C_0805_2012Metric; LCSC C28233
C25: 10uF/50V; C_1206_3216Metric; LCSC C13585
C26: 0.1uF/50V; C_1206_3216Metric; LCSC C24497
C27: 10uF; C_1206_3216Metric; LCSC C13585
C28: 0.1uF; C_1206_3216Metric; LCSC C24497
D10: TPSMB24A; C151306_SMB_L4_6-W3_6-LS5_3-RD; LCSC C151306
D12: SBR3U40P1-7; C97127_POWERDI-123_L2_8-W1_8-LS3_7-RD; LCSC C97127
D13: 1N5819HW-7-F; D_SOD-323_HandSoldering; LCSC C191023
F1: XF-508P-B-B; C19727305_FUSE-TH_4P-L16_0-W6_7; LCSC C19727305
J9: Conn_01x02_Socket; PinSocket_1x02_P2.54mm_Vertical; LCSC C49661
JP1: Conn_01x02_Pin; PinHeader_1x02_P2.54mm_Vertical; LCSC C5116481; not fitted
L1: 4.7uH; L_Changjiang_FNR5020S; LCSC C167930
R34: 15k; R_0603_1608Metric; LCSC C22809
R35: 100k; R_0603_1608Metric; LCSC C25803
U10: AP63205WU; TSOT-23-6; LCSC C2071056

Connections:
+5V: C21.1, C22.1, L1.2, U10.1 (FB)
+12V_ACC: D13.2 (A)
+12V_BATT: F1.1, F1.4
+12V_FUSED_BATT: D12.2 (A), F1.2, F1.3, J9.2
GND: C21.2, C22.2, C25.2, C26.2, C27.2, C28.2, D10.2, R34.1, U10.4 (GND)
unnamed: C23.1, L1.1, U10.5 (SW)
unnamed: C23.2, U10.6 (BST)
unnamed: C25.1, C26.1, D10.1, D12.1 (C), U10.3 (IN)
unnamed: C27.1, C28.1, JP1.2 (B), R34.2, R35.2, U10.2 (EN)
unnamed: D13.1 (C), J9.1, JP1.1 (A), R35.1

Notes on the sheet:
Access to +12V Batt and ACC
Jumper serves two purposes. Provide access to accessory +12V power and ability to bypass voltage divider.
Diode to prevent backflow in case of miswiring to the car. TVS diode for overvoltage conditions. Will clamp at a max of ~39V. The AP6320WU can withstand +40V for 400ms.
mini blade fuse
Buck Converter to +5V. Buck Converter powered by battery and enabled by accessory signal
