lodewave/miata-na-cd/hardware/kicad/usbc_uart.kicad_sch

## KiCad design hardware/kicad/usbc_uart.kicad_sch (2026-10-19)

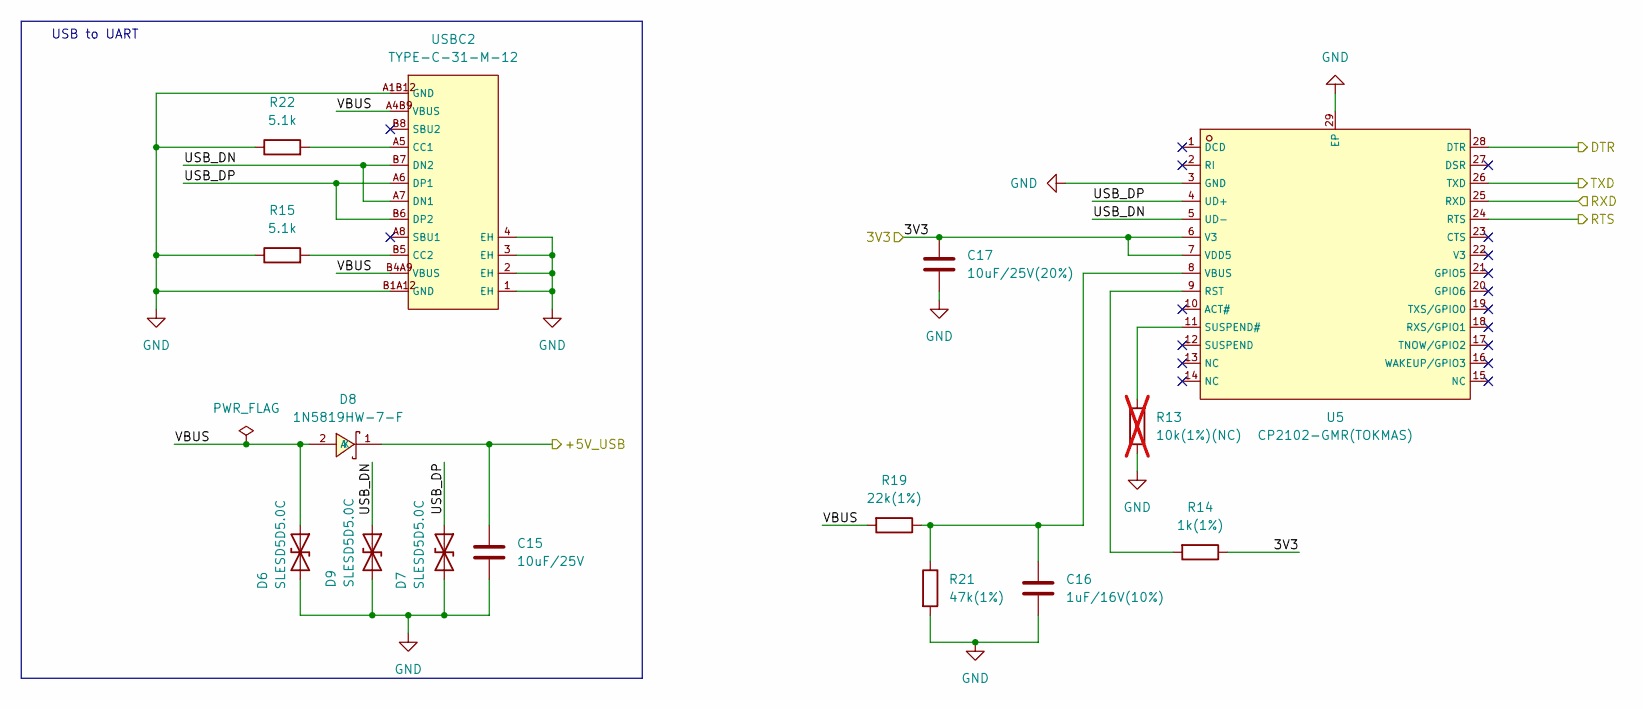
[picture p11: schematic usbc_uart.kicad_sch]

Parts:
C15: 10uF/25V; C_0603_1608Metric; LCSC C96446
C16: 1uF/16V(10%); C_0603_1608Metric; LCSC C15849
C17: 10uF/25V(20%); C_0603_1608Metric; LCSC C96446
D6, D7, D9: SLESD5D5.0C; D_SOD-523; LCSC C52311731
D8: 1N5819HW-7-F; D_SOD-323_HandSoldering; LCSC C191023
R13: 10k(1%)(NC); R_0603_1608Metric; LCSC C25804; not fitted
R14: 1k(1%); R_0603_1608Metric; LCSC C21190
R15, R22: 5.1k; R_0603_1608Metric; LCSC C23186
R19: 22k(1%); R_0603_1608Metric; LCSC C31850
R21: 47k(1%); R_0603_1608Metric; LCSC C25819
U5: CP2102-GMR(TOKMAS); C54581988_QFN-28_L5_0-W5_0-P0_50-TL-EP3_3; LCSC C6568
USBC2: TYPE-C-31-M-12; C165948_USB-C_SMD-TYPE-C-31-M-12_1; LCSC C165948

Connections:
3V3: C17.1, R14.1, U5.6 (V3), U5.7 (VDD5)
+5V_USB: C15.1, D8.1 (K)
DTR: U5.28 (DTR)
GND: C15.2, C16.1, C17.2, D6.2 (A2), D7.2 (A2), D9.2 (A2), R13.1, R15.1, R21.2, R22.1, U5.3 (GND), U5.29 (EP), USBC2.1 (EH), USBC2.2 (EH), USBC2.3 (EH), USBC2.4 (EH), USBC2.A1B12 (GND), USBC2.B1A12 (GND)
unnamed: C16.2, R19.1, R21.1, U5.8 (VBUS)
unnamed: R13.2, U5.11 (SUSPEND#)
unnamed: R14.2, U5.9 (RST)
unnamed: R15.2, USBC2.B5 (CC2)
unnamed: R22.2, USBC2.A5 (CC1)
RTS: U5.24 (RTS)
RXD: U5.25 (RXD)
TXD: U5.26 (TXD)
USB_DN: D9.1 (A1), U5.5 (UD-), USBC2.A7 (DN1), USBC2.B7 (DN2)
USB_DP: D7.1 (A1), U5.4 (UD+), USBC2.A6 (DP1), USBC2.B6 (DP2)
VBUS: D6.1 (A1), D8.2 (A), R19.2, USBC2.A4B9 (VBUS), USBC2.B4A9 (VBUS)

Notes on the sheet:
USB to UART
