lodewave/miata-na-cd/firmware/primary_esp32s3/DSEG14Classic_Regular_18.h

const uint8_t DSEG14Classic_Regular18pt7bBitmaps[] PROGMEM = {
  0x00, 0x00, 0x40, 0x07, 0x00, 0x3C, 0x0F, 0xE0, 0x7F, 0x03, 0xF8, 0x1F,
  0xC0, 0xFE, 0x07, 0xF0, 0x3F, 0x81, 0xFC, 0x0F, 0xE0, 0x7F, 0x03, 0xF0,
  0x0B, 0x00, 0x00, 0xFF, 0xC0, 0x60, 0x30, 0x18, 0x0C, 0x06, 0x03, 0x01,
  0x80, 0xC0, 0x60, 0x30, 0x18, 0x0C, 0x06, 0x03, 0x01, 0x80, 0xC0, 0x60,
  0x30, 0x18, 0x0C, 0x07, 0xFE, 0x1F, 0xFF, 0xF0, 0xFF, 0xFF, 0xC5, 0xFF,
  0xFE, 0x38, 0x00, 0x00, 0xF0, 0x38, 0x03, 0xC0, 0xE0, 0x0F, 0x03, 0x80,
  0x3C, 0x0E, 0x00, 0xF0, 0x38, 0x03, 0xC0, 0xE0, 0x0F, 0x03, 0x80, 0x3C,
  0x0E, 0x00, 0xF0, 0x38, 0x03, 0xC0, 0xE0, 0x0F, 0x03, 0x80, 0x38, 0x04,
  0x00, 0xDF, 0xCF, 0xE0, 0xFF, 0xBF, 0xC1, 0xFC, 0xFF, 0xC0, 0x04, 0x07,
  0x00, 0x38, 0x1C, 0x00, 0xE0, 0x70, 0x03, 0x81, 0xC0, 0x0E, 0x07, 0x00,
  0x38, 0x1C, 0x00, 0xE0, 0x70, 0x03, 0x81, 0xC0, 0x0E, 0x07, 0x00, 0x38,
  0x1C, 0x00, 0xE0, 0x70, 0x03, 0x81, 0xC0, 0x00, 0x07, 0x1F, 0xFF, 0xEC,
  0xFF, 0xFF, 0xC1, 0xFF, 0xFF, 0x00, 0x40, 0x00, 0x03, 0x80, 0x00, 0x0F,
  0xC0, 0x04, 0x3F, 0x00, 0x30, 0xFE, 0x00, 0xC3, 0xF8, 0x07, 0x0F, 0xF0,
  0x1C, 0x3D, 0xE0, 0xF0, 0xF7, 0x83, 0x83, 0xCE, 0x0E, 0x0F, 0x18, 0x30,
  0x3C, 0x60, 0x80, 0xF0, 0x82, 0x03, 0x80, 0x00, 0x0D, 0xFC, 0xFE, 0x0F,
  0xFB, 0xFC, 0x1F, 0xCF, 0xFC, 0x00, 0x00, 0x70, 0x08, 0x21, 0xC0, 0x60,
  0x87, 0x01, 0x83, 0x1C, 0x0E, 0x0E, 0x70, 0x78, 0x39, 0xC1, 0xE0, 0xF7,
  0x0F, 0x01, 0xDC, 0x38, 0x07, 0x70, 0xE0, 0x0D, 0xC3, 0x00, 0x37, 0x0C,
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
  {  2455,  22,  31,  29,    3,  -32 },   // 0x48 'H'
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

const GFXfont DSEG14Classic_Regular18pt7b PROGMEM = {
  (uint8_t  *)DSEG14Classic_Regular18pt7bBitmaps,
  (GFXglyph *)DSEG14Classic_Regular18pt7bGlyphs,
  0x20, 0x7E, 38 };

// Approx. 7182 bytes
