lodewave/miata-na-cd/(notices)

Notices in the files:
firmware/primary_esp32s3/primary_esp32s3.ino:
Copyright (C) 2026 lodewave
under the terms of the GNU General Public License as published by the Free
any later version. This program is distributed WITHOUT ANY WARRANTY. See
the GNU General Public License (LICENSE at the repo root) for details.
